wagiminator/ATtiny412-USB-Power-Isolator/documentation/USB_Power_Isolator_perf2.png

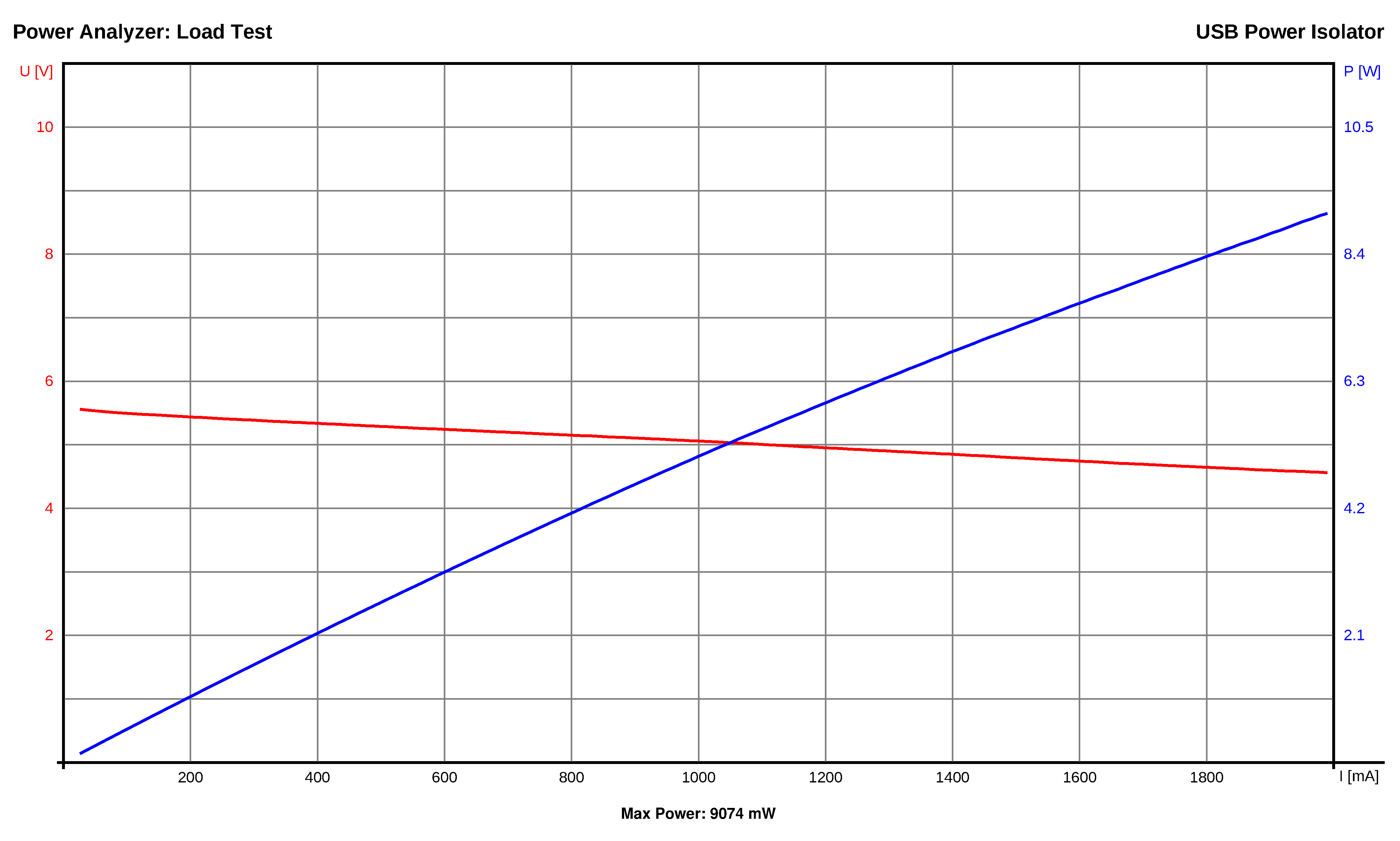
documentation/USB_Power_Isolator_perf2.png
