wagiminator/ATtiny412-USB-Power-Isolator/documentation/USB_Power_Isolator_pic3.jpg

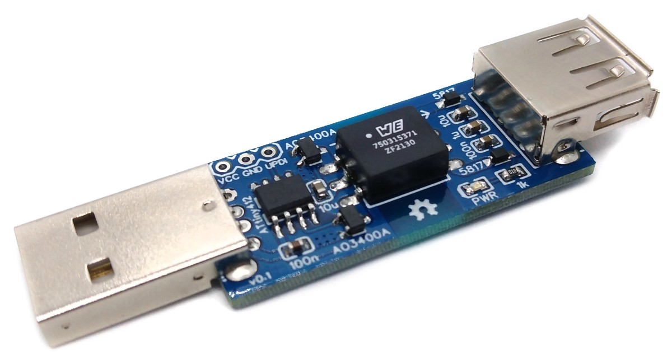
documentation/USB_Power_Isolator_pic3.jpg
