wagiminator/ATtiny412-USB-Power-Isolator/hardware/USB_Power_Isolator_BOM.tsv

ID | Name | Designator | Footprint | Quantity | Manufacturer Part | Manufacturer | Supplier | Supplier Part | Price
1 | 100n | C1,C3 | C_0603 | 2 | CC0603KRX7R9BB104 | YAGEO | LCSC | C14663 | 0.002
2 | 10u | C2,C5 | C_0603 | 2 | CL10A106KP8NNNC | SAMSUNG | LCSC | C19702 | 0.003
3 | 1u | C4 | C_0603 | 1 | CL10A105KB8NNNC | SAMSUNG | LCSC | C15849 | 0.003
4 | UPDI | CN1 | 210S-3X1/2.54 | 1 | Header2.54mm 1*3P | BOOMELE | LCSC | C49257 | 0.015
5 | 5817 | D1,D2 | SCHOTTKY_SOD_323 | 2 | 1N5817WS | TWGMC | LCSC | C727114 | 0.024
6 | PWR | LED1 | LED_0603 | 1 | KT-0603R | KENTO | LCSC | C2286
7 | AO3400A | Q1,Q2 | SOT-23-3_W | 2 | AO3400A | Youtai Semiconductor Co., Ltd. | LCSC | C347475 | 0.03
8 | 1k | R1 | 0603 | 1 | 0603WAF1001T5E | UniOhm | LCSC | C21190
9 | 10k | R2,R3 | 0603 | 2 | 0603WAF1002T5E | UniOhm | LCSC | C25804
10 | WE750315371 | T1 | WE750315371 | 1 | 750315371 | Würth Elektronik | Digi-Key | 1297-1178-2-ND
11 | ATTINY412-SSN | U1 | SOP-8_150MIL | 1 | ATTINY412-SSN | MICROCHIP(美国微芯) | LCSC | C1338223 | 0.577
12 | UPSTREAM | USB1 | USB-M-48-2 | 1 | USB-05 | SOFNG | LCSC | C112454 | 0.096
13 | DOWNSTREAM | USB2 | USB-2.0-A-F | 1 | USB-A-F-90 | LCSC | LCSC | C168708
