wagiminator/ATtiny412-USB-Power-Isolator/hardware/USB_Power_Isolator_schematic.pdf

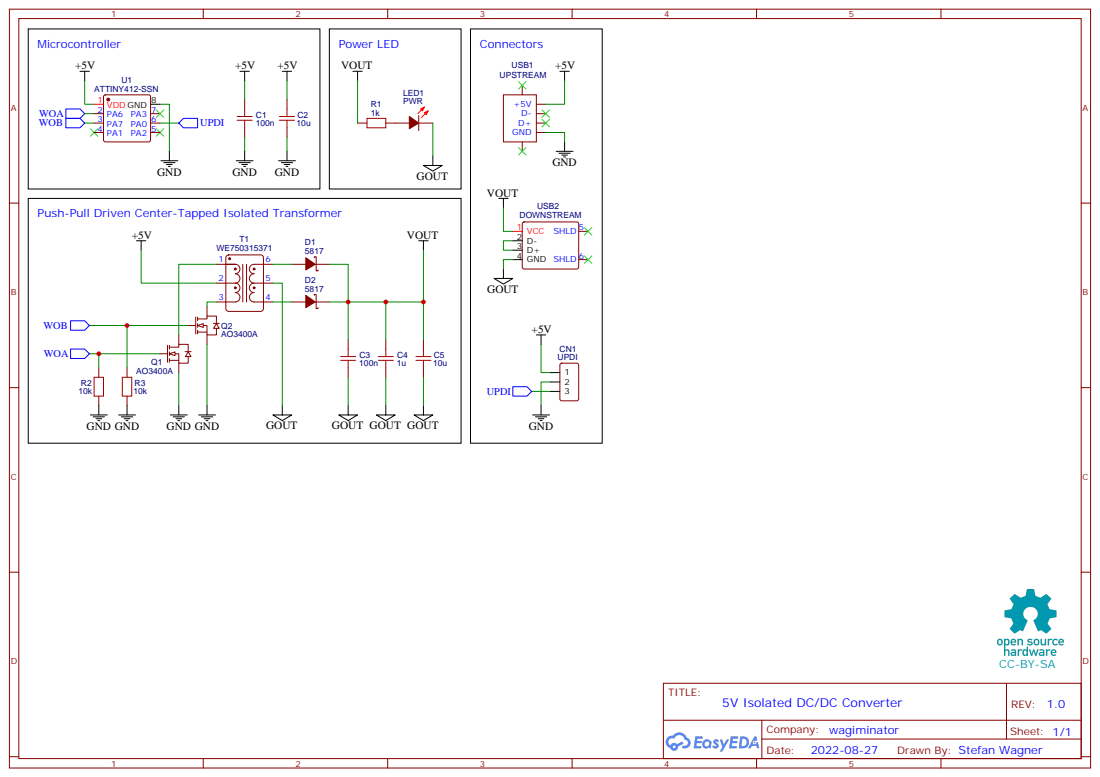
[picture p17: page 1]

Push-Pull Driven Center-Tapped Isolated Transformer

Drawn By: Stefan Wagner
