wagiminator/ATtiny412-USB-Power-Isolator/hardware/USB_Split_Power_Isolator_schematic.pdf

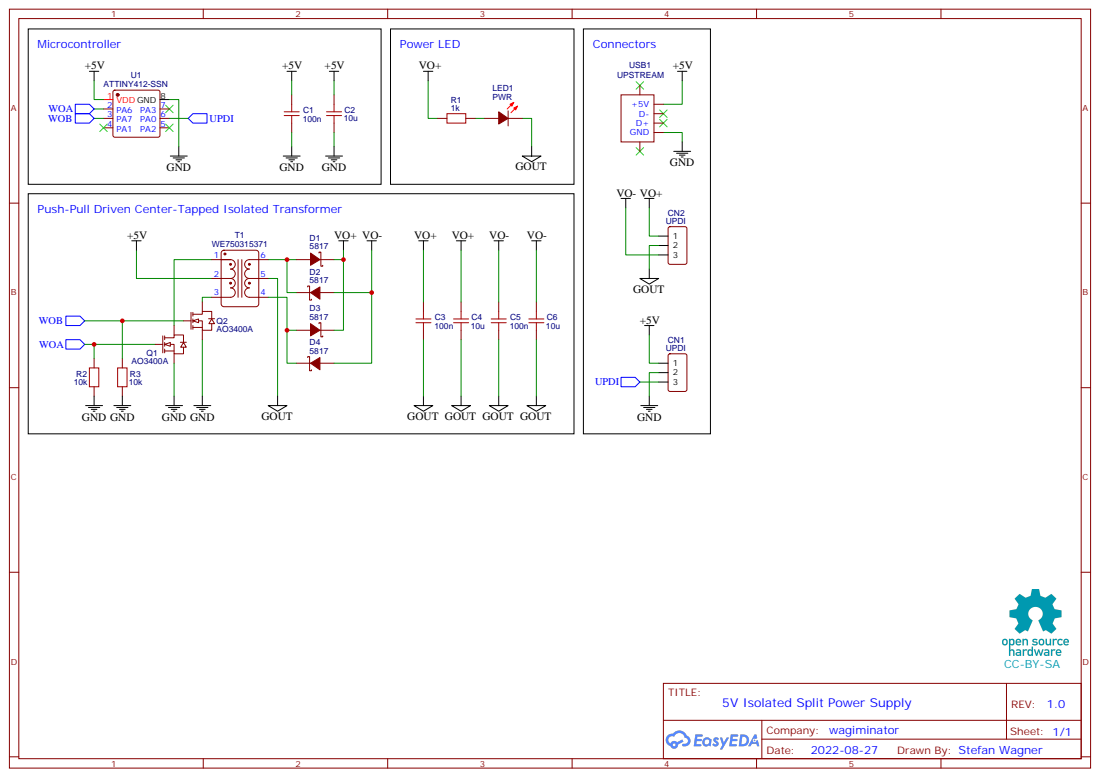
[picture p18: page 1]

Push-Pull Driven Center-Tapped Isolated Transformer

Drawn By: Stefan Wagner
