wagiminator/ATtiny412-USB-Power-Isolator/documentation/USB_Power_Isolator_wiring1.png

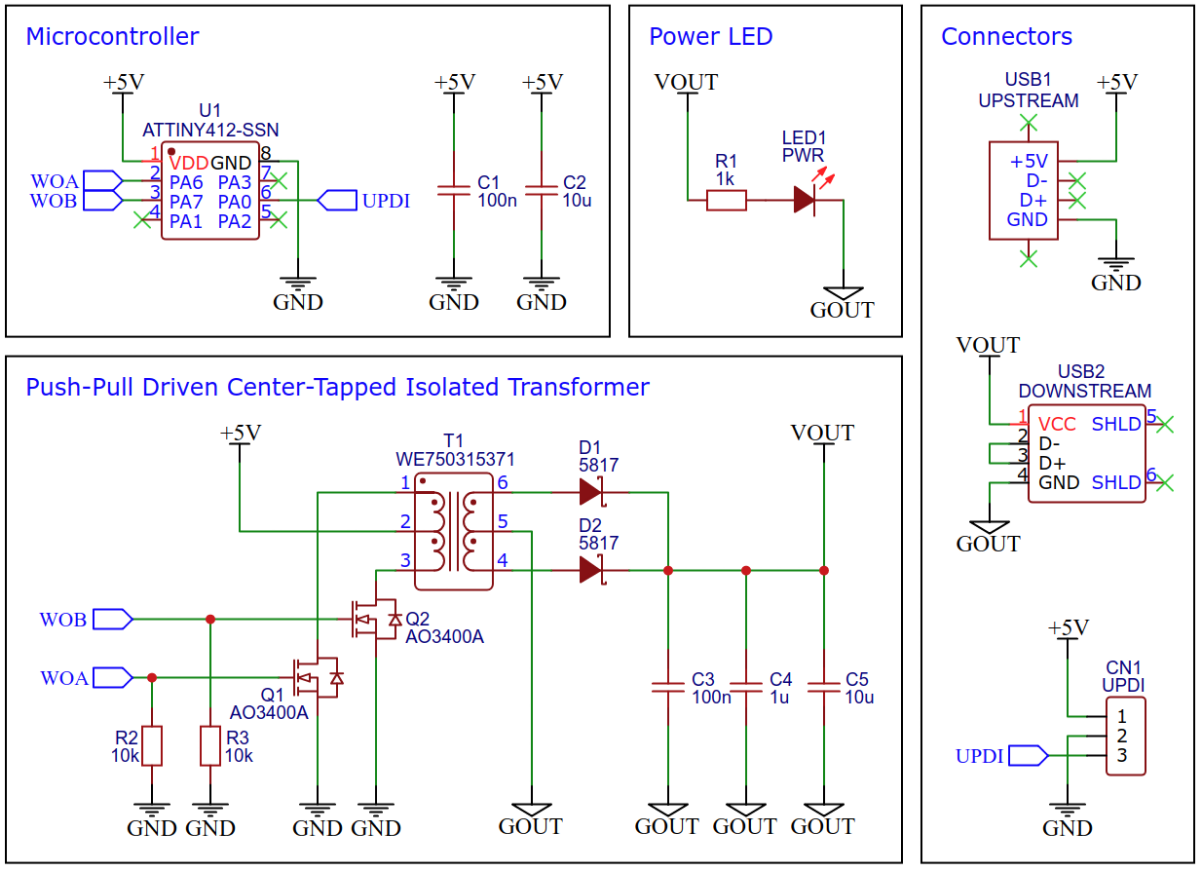
documentation/USB_Power_Isolator_wiring1.png
